AseelKurdy/smart-parking-lot/docs/poster.pdf

## Smart Parking

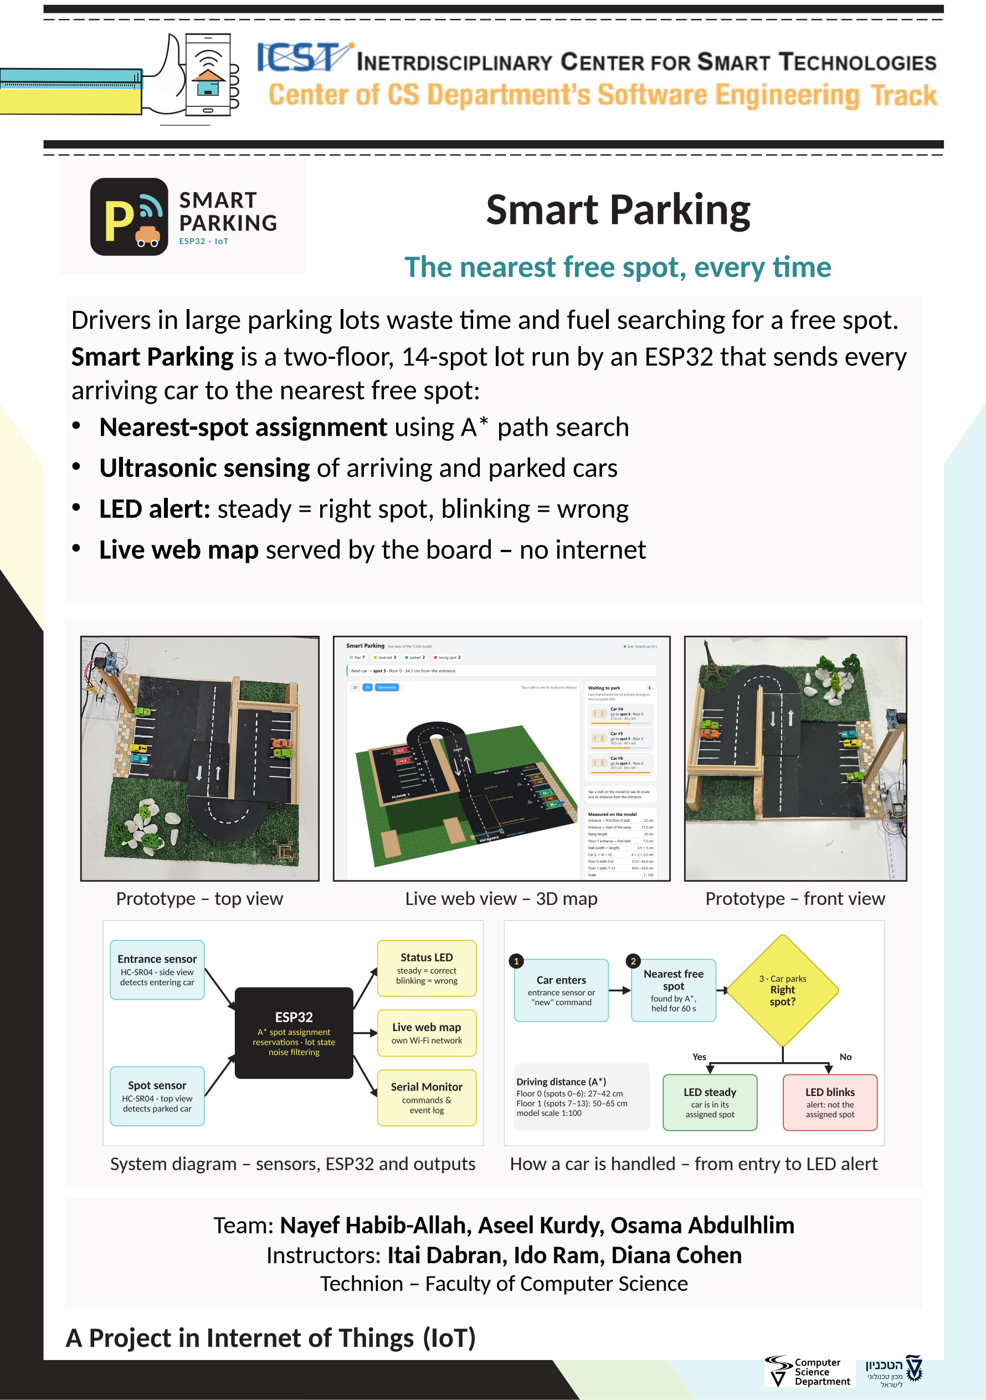
[picture p11: page 1]

A Project in Internet of Things (IoT)

The nearest free spot, every time Drivers in large parking lots waste time and fuel searching for a free spot. Smart Parking is a two-floor, 14-spot lot run by an ESP32 that sends every arriving car to the nearest free spot:
- Nearest-spot assignment using A* path search
- Ultrasonic sensing of arriving and parked cars
- LED alert: steady = right spot, blinking = wrong
- Live web map served by the board – no internet

Team: Nayef Habib-Allah, Aseel Kurdy, Osama Abdulhlim Instructors: Itai Dabran, Ido Ram, Diana Cohen Technion – Faculty of Computer Science

Prototype – top view | Live web view – 3D map | Prototype – front view
System diagram – sensors, ESP32 and outputs | How a car is handled – from entry to LED alert
