AseelKurdy/smart-parking-lot/docs/project_documentation.pdf

Smart Parking · Aseel Kurdy · Nayef Habiballah · Osama Abdulhalim · 1 / 12

# חניון חכם — תיעוד הפרויקט

### מערכת ניהול חניון מבוססת 32ESP עם חיישני אולטרסאונד והקצאת חניות בעזרת A*

| גרסת המסמך 2.1
)2026 אוקטובר , שנמדד דגם )parking_page.h + smart_parking_v9.ino | המתועדת התוכנה גרסת
| תאריך 24/10/2026
Aseel Kurdy, Nayef Habiballah, Osama Abdulhalim | מגישים
Itai Dabran, Ido Ram, Diana Cohen | מנחים
github.com/AseelKurdy/smart-parking-lot | המקור קוד

Smart Parking · Aseel Kurdy · Nayef Habiballah · Osama Abdulhalim · 2 / 12

## .1 תקציר מנהלים

המערכת מנהלת חניון חכם בן שתי קומות ו14- חניות, הבנוי כדגם פיזי בקנה מידה .1:100 כאשר רכב נכנס לחניון, המערכת מקצה לו אוטומטית את החניה הפנויה הקרובה ביותר לכניסה, לפי מרחק נסיעה שמחושב באלגוריתם A* על גבי רשת הדרכים של הדגם — במרחקים שנמדדו על הדגם עצמו. אם הרכב חונה בחניה שהוקצתה לו — נורית החניה דולקת באור קבוע; אם הוא חונה בחניה אחרת — הנורית מהבהבת כאתראה. מתוך 14 החניות, חניה אחת )מספר 0( ממומשת בחומרה אמיתית עם חיישן אולטרסאונד ונורית; 13 הנותרות וירטואליות ונשלטות דרך ה-Monitor Serial. חיישן נוסף בכניסה מזהה כל רכב שנכנס. בנוסף לממשק הטקסטואלי, הלוח מגיש עמוד אינטרנט גרפי שמצייר את הדגם עצמו במבט מלמעלה — שתי הקומות, הרמפה וה-U, החניות והרכבים בפרופורציות האמיתיות — ומעדכן אותו בזמן אמת, כולל תצוגת D3 שבה קומה 1 מורמת מעל קומה .0

## .2 הגדרת הבעיה והדרישות

### 2.1 הבעיה

בחניונים גדולים נהגים מבזבזים זמן ודלק בחיפוש אחר חניה פנויה. חניון חכם שיודע אילו חניות פנויות ומכוון כל רכב לחניה ספציפית יכול לקצר את מרחק הנסיעה בתוך החניון.

### 2.2 דרישות פונקציונליות

# דרישה מימוש

1F זיהוי רכב הנכנס לחניון )חישה מהצד( חיישן 04SR-HC בכניסה

2F זיהוי רכב החונה בחניה )חישה מלמעלה( חיישן 04SR-HC מעל חניה 0

3F הקצאת חניה לרכב נכנס A *על רשת הדרכים — החניה הפנויה הקרובה ביותר

4F זיהוי חניה במקום שגוי השוואה בין החניה המשוריינת לחניה בפועל

5F אתראה על חניה שגויה נורית מהבהבת )300 ms)

6F זיהוי מספר רכב לא ממומש בדרישות הפרויקט — מדומה במונה מזהים עולה

7F חניות וירטואליות נוספות 13 חניות נשלטות דרך ה-Monitor Serial

8F הדמיה ויזואלית של מצב החניון עמוד אינטרנט שהלוח מגיש בעצמו, מחקה את הדגם ב-D/3D2

### 2.3 דרישות לא-פונקציונליות

המערכת פועלת עצמאית, ללא חיבור לאינטרנט או לשרת חיצוני. זמן תגובה: רכב בכניסה ~1.1 שניות )2 דגימות(, רכב בחניה 0 ~2 שניות )4 דגימות × 500 ms). עמידות בפני רעש חשמלי בקריאות החיישנים. הפלט הטקסטואלי באנגלית בלבד — ה-Monitor Serial של IDE Arduino אינו תומך בכיווניות מימין לשמאל.

Smart Parking · Aseel Kurdy · Nayef Habiballah · Osama Abdulhalim · 3 / 12

## .3 ארכיטקטורת המערכת

### 3.1 שכבות

┌──────────────────────────────────────────────────────┐
│ Browser (phone / laptop) | │
│ parking_page.h -> HTML + CSS + JavaScript | │
│ draws the model (SVG, 2D/3D) from JSON, every 1 s | │
└───────────────────────┬──────────────────────────────┘ │ HTTP over WiFi AP "SmartParking"
│ GET / | -> the page
│ GET /state | -> JSON (~1.5 KB)
┌───────────────────────┴──────────────────────────────┐
│ ESP32 - smart_parking_v9.ino | │
│ ┌────────────┬──────────────┬─────────────────────┐ │
│ │ sensors | │ lot logic | │ output | │ │
│ │ sampling | │ road network │ JSON, Serial, LED | │ │
│ │ hysteresis │ A*, states | │ text map (fallback) │ │
│ └────────────┴──────────────┴─────────────────────┘ │ └──────┬────────────────────────────────────┬──────────┘
HC-SR04 x2 | LED GPIO2
(entrance, spot 0)
| ▲
│ Serial 9600 - operator commands

### 3.2 חלוקת האחריות

רכיב אחריות

32ESP דגימת חיישנים, חישוב A*, ניהול מצב החניון, הגשת JSON ו-HTTP

דפדפן כל הציור הגרפי — ה32-ESP אינו מייצר תמונה, רק נתונים

Monitor Serial קלט פקודות + יומן אירועים )וציור טקסט כגיבוי כשאין WiFi)

נורית 2GPIO אתראה על חניה 0 בלבד

הפרדה זו נבחרה במכוון: ציור על ה32-ESP היה צורך זיכרון ו-CPU מיותרים, בעוד שהדפדפן מצייר בחינם מנתונים קומפקטיים.

Smart Parking · Aseel Kurdy · Nayef Habiballah · Osama Abdulhalim · 4 / 12

## .4 החומרה

### 4.1 רשימת רכיבים

| | רכיב כמות תפקיד
ראשי בקר | 1 | ( USB: CH9102 שבב )ESP32-WROOM32 DevKit
| | 04SR-HC — חיישן אולטרסאונד 2 זיהוי כניסה וזיהוי חניה
| | Breadboard 2 חיווט
| | חוטי Jumper 8 חיבור החיישנים
| | כבל USB 1 הזנה ותקשורת
| | נורית LED — מובנית בלוח )2GPIO)
| | דגם החניון 1 לוח עם דשא, כביש ראשי, קומה ,0 רמפה ומשטח מוגבה )קומה 1(

### 4.2 חיווט

Echo | Trig | GND | Vcc | תפקיד
D14 | D27 | GND | VIN (5 V) | ) מהצד ) כניסה חיישן
D25 | D26 | GND | VIN (5 V) | ) מלמעלה )0 חניה חיישן
| | | | נורית אתראה — — — 2GPIO( מובנה(

הערה על מתח: ה04-SR-HC מחזיר פולס Echo ברמת 5 V, ופיני ה32-ESP מיועדים ל3.3- V. בפרויקט זה, לפי אישור מפורש של המנחה, החיישנים חוברו ישירות ללא מחלק מתח. המערכת פעלה ללא תקלה, אך זו חריגה מהמפרט הרשמי.

### 4.3 כיול החיישנים )נמדד על הדגם(

| | | חיישן ללא רכב עם רכב הסף בקוד
ס"מ | ~22 ס"מ רכב נספר מתחת ל25.0- | החיישן( | כניסה )מהצד( ~30 ס"מ )הקיר שמול
מגיע מתחת ל,24.7- יוצא מעל 24.9 | ס"מ(: 23.5–24.5 | 25–26 ס"מ רכב בגובה 2.5 ס"מ: 22.5–23.5; רכב נמוך )1.5 | חניה 0 )מלמעלה(
נקבע | , | בכניסה | הזיהוי | סף )GATE_CAR_BELOW_CM = 25.0 , GATE_ENTRY_CM = 22.0 , GATE_EMPTY_CM = 30.0 :בקוד
. SPOT_LEAVE_CM = 24.9 , SPOT_ARRIVE_CM = 24.7 ,) | ישירות
על המרווחים בחניה :0 הספים נבחרו כך שגם רכב נמוך, בגובה 1.5 ס"מ, ייקלט. בין הקריאה הרחוקה ביותר של רכב כזה )24.5( לבין הקריאה הקרובה ביותר בלי רכב )25.0( יש רק 0.5 ס"מ, ולכן נשארים כ0.2- ס"מ מצד הרכב וכ0.1-ס"מ מצד החניה הריקה — ברמת הדיוק של ה04-SR-HC. ההיסטרזיס )שני ספים( והדרישה ל4- דגימות רצופות הם שמונעים קפיצות. אם יש קפיצות, מודדים עם 10 check ומזיזים את הספים, או מגביהים את החיישן כך שהחניה הריקה תקרא רחוק יותר.

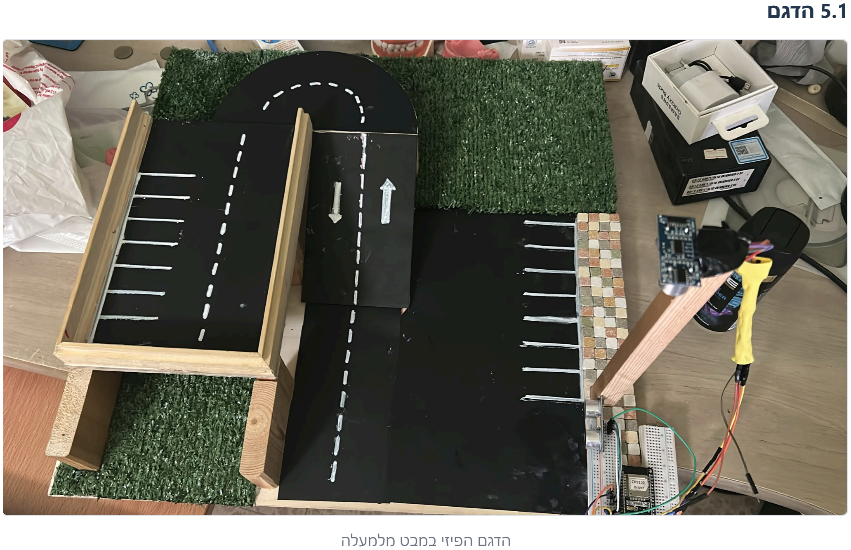
[picture p17: figure]
5.1 הדגם; הדגם הפיזי במבט מלמעלה

Smart Parking · Aseel Kurdy · Nayef Habiballah · Osama Abdulhalim · 5 / 12

## .5 מודל החניון

הכביש הראשי נכנס מלמטה. קומה 0 היא השטח הפתוח מימין לכביש, עם 7 החניות לאורך הקיר הימני — חניה ,0 הקרובה לכניסה, למטה, ועליה חיישן החניה. הרמפה מתחילה על הכביש הראשי עוד לפני חניות קומה ,0 עולה )קטע דו-סטרי( ומסתובבת ב-U אל קומה 1 — המשטח המוגבה משמאל, עם 7 החניות לאורך צדו השמאלי; חניה 7 היא הראשונה מכניסת הקומה.

### 5.2 מידות שנמדדו

| | גודל ערך קבוע בקוד
, CAR_WIDTH_CM , CAR_LENGTH_CM CAR_HEIGHT_CM | ס"מ | רכב )אורך × רוחב × גובה( 4 × 2 × 2.5
SPOT_LENGTH_CM , SPOT_WIDTH_CM | מ"ס 5 × 2.5 | ( אורך × רוחב ) חניה
| | כניסה ← ממש לפני החניה הראשונה בקומה 0 22 ס"מ CM_0FLOOR_TO_ENT
| | כניסה ← תחילת הרמפה 17.5 ס"מ CM_RAMP_TO_ENT
| | אורך הרמפה )עד הכניסה לקומה 1( 20 ס"מ CM_RAMP
FLOOR1_TO_FIRST_CM | מ"ס 7.5 | כניסה לקומה 1 ← ממש לפני החניה הראשונה בה

קנה מידה :1:100 חניה של 2.5 × 5 ס"מ בדגם היא בדיוק חניה סטנדרטית של 2.5 × 5 מ', ורכב של 4 × 2 ס"מ הוא רכב של 4 × 2 מ'. לכן כל ס"מ בדגם הוא מטר בחניון אמיתי — אותם מספרים.

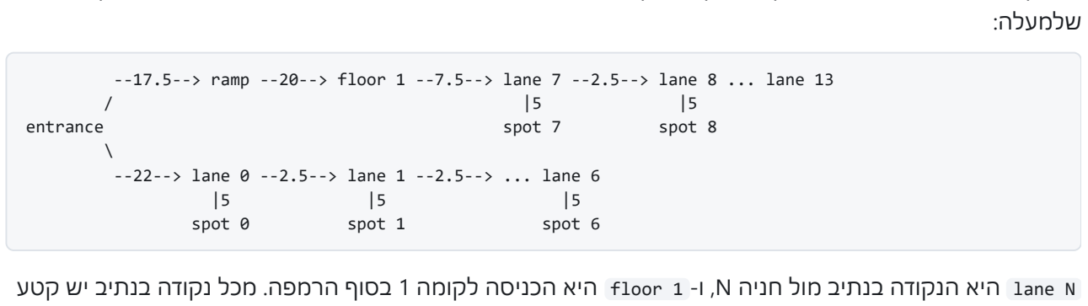
[picture p18: figure]
שלמעלה:; entrance; spot 7; spot 8; spot 0; spot 1; spot 6

Smart Parking · Aseel Kurdy · Nayef Habiballah · Osama Abdulhalim · 6 / 12

### 5.3 רשת הדרכים

החניון מיוצג כרשת של צמתים וקטעי דרך באורך שנמדד. הרשת נבנית בהפעלה ) buildRoadNetwork ) מהקבועים

--17.5--> ramp --20--> floor 1 --7.5--> lane 7 --2.5--> lane 8 ... lane 13

--22--> lane 0 --2.5--> lane 1 --2.5--> ... lane 6

N lane היא הנקודה בנתיב מול חניה N, ו- 1 floor היא הכניסה לקומה 1 בסוף הרמפה. מכל נקודה בנתיב יש קטע של 5 ס"מ )אורך החניה( לתוך החניה שמולה. אי אפשר לנסוע דרך חניה — חניה היא רק יעד.

### 5.4 מרחקי הנסיעה המתקבלים

חניה קומה מרחק מהכניסה בחניון אמיתי )1:100(

0 )פיזית( 0 27.0 ס"מ 27.0 מ'

1 0 29.5 ס"מ 29.5 מ'

2 0 32.0 ס"מ 32.0 מ'

3 0 34.5 ס"מ 34.5 מ'

4 0 37.0 ס"מ 37.0 מ'

5 0 39.5 ס"מ 39.5 מ'

6 0 42.0 ס"מ 42.0 מ'

7 1 50.0 ס"מ 50.0 מ'

8 1 52.5 ס"מ 52.5 מ'

9 1 55.0 ס"מ 55.0 מ'

10 1 57.5 ס"מ 57.5 מ'

11 1 60.0 ס"מ 60.0 מ'
12 1 62.5 ס"מ 62.5 מ'

13 1 65.0 ס"מ 65.0 מ'

לדוגמה: חניה 0 = 22 )עד מול החניה( + 5 )לתוך החניה( = 27.0; חניה 7 = 17.5 + 20 + 7.5 + 5 = 50.0; וכל חניה נוספת באותה קומה מוסיפה .2.5 ה-A *מחשב את כל הערכים האלה מהרשת, ובדיקה אוטומטית משווה אותם לנוסחה הזו )סעיף 10(.
גרסת המחקר ) research_9v_parking_smart ) זהה בדיוק, אבל מציגה את אותם מספרים כמטרים של חניון אמיתי — כמו בסימולציה ובדו"ח.

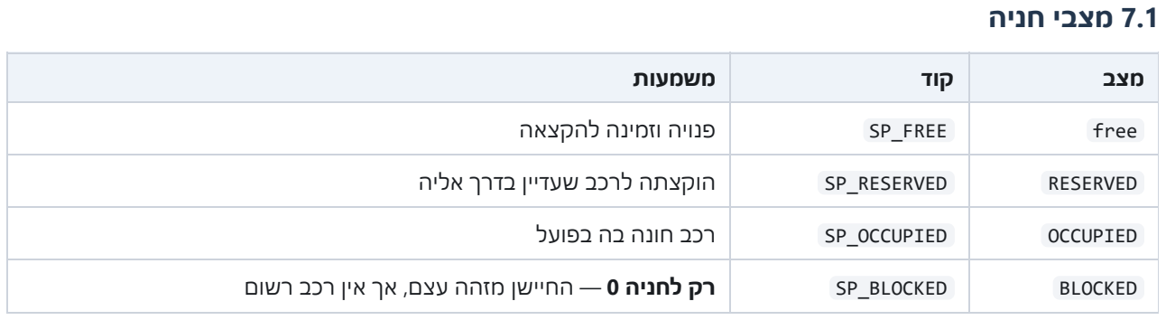
[picture p19: figure]
7.1 מצבי חניה; מצב קוד משמעות; free FREE_SP פנויה וזמינה להקצאה

Smart Parking · Aseel Kurdy · Nayef Habiballah · Osama Abdulhalim · 7 / 12

## .6 אלגוריתם ההקצאה

### 6.1 הבחירה

נבחר A *לפי דרישת הפרויקט. מרחב החיפוש הוא רשת הדרכים: 31 צמתים )כניסה, תחילת רמפה, כניסה לקומה ,1 נקודה בנתיב מול כל אחת מ14- החניות, ובתוך כל חניה( ו30- קטעי דרך.

### 6.2 למה רשת ולא טבלה

בגרסאות קודמות החניון היה טבלה )grid )עם צעד קבוע. במדידות של הדגם הרמפה מתחילה לפני חניות קומה 0 )17.5 ס"מ מול 22 ס"מ(, והקטע הראשון ארוך בהרבה מהמרווח בין החניות — טבלה עם צעד קבוע לא יכולה לייצג את זה. ברשת כל קטע מקבל את אורכו המדוד.

h(n) = SPOT_LENGTH_CM | if n is not on the goal's lane
h(n) = |position of n on the lane - position of the goal| * SPOT_WIDTH_CM + SPOT_LENGTH_CM

הוכחת קבילות )admissibility): כל מסלול לחניה מסתיים בקטע של 5 ס"מ לתוך החניה, ולכן CM_LENGTH_SPOT אינו גדול מהמרחק שנשאר. מנקודה על הנתיב של אותה קומה צריך בנוסף לנסוע לאורך הנתיב עד מול החניה — לפחות מספר החניות שביניהן כפול .2.5 לכן h אף פעם אינה מעריכה ביתר, ו-A *מחזיר את המסלול הקצר ביותר.

### 6.4 מימוש

החישוב מתבצע פעם אחת. הדגם קבוע, ולכן ()computeSpotDistances בונה את הרשת ומריצה A *ל14-היעדים ב- ()setup . בזמן ריצה לא מתבצע חיפוש. אין סגירת צמתים )set closed): צומת יכול להיפתח מחדש אם נמצא לו מסלול זול יותר. ברשת בת 31 צמתים העלות זניחה.
הערה על יעילות: כיוון שהכניסה קבועה, ריצה אחת של Dijkstra הייתה מחזירה את כל המרחקים בבת אחת. ההבדל זניח, ו-A *נבחר כפי שהוגדר בדרישות.

## .7 מודל המצב

RESERVED RESERVED_SP הוקצתה לרכב שעדיין בדרך אליה

OCCUPIED OCCUPIED_SP רכב חונה בה בפועל

BLOCKED BLOCKED_SP רק לחניה 0 — החיישן מזהה עצם, אך אין רכב רשום

סדר העדיפויות: תפוסה ← משוריינת ← חסומה ← פנויה. מצב BLOCKED נדרש משום שהחיישן אינו יודע מי נמצא בחניה; חפץ שמונח שם בלי שרכב הוקצה לא משויך לאף רכב, והחניה אינה מוקצית עד שתתפנה.

Smart Parking · Aseel Kurdy · Nayef Habiballah · Osama Abdulhalim · 8 / 12

### 7.2 מעגל החיים של רכב

[new / entrance sensor]
│
▼
┌─────────────┐
│ RESERVED │ <- A* picked a stall; 60 s timer runs └──┬───────┬──┘
park | │ | │ timeout 60 s
│ | | └───────────┐
▼ | | ▼
┌────────────┐ | ┌───────────────┐
│ PARKED | │ | │ in the lot, | │
│ right/wrong│ | │ no stall | │
└─────┬──────┘ | └──────┬────────┘
│ leave / spot-0 | │ park (always WRONG)
│ sensor clears | │
▼ | | ▼
┌─────────────────────────────┐
│ | left the lot | │
└─────────────────────────────┘

### 7.3 מנגנון השריון

כשרכב נכנס, החניה שהוקצתה לו מסומנת RESERVED ואינה מוצעת לרכבים אחרים )תיקון לבאג מוקדם שבו כל רכב חדש קיבל את אותה חניה(. השריון פוקע לאחר 60 שניות; הרכב נשאר בחניון ויכול עדיין לחנות, אך כל חניה שיתפוס תסומן כשגויה.

### 7.4 השתלטות על חניה משוריינת

אם רכב א' חונה בחניה שהוקצתה לרכב ב', המערכת אינה דוחה את הפעולה — פיזית אי אפשר למנוע זאת. החניה נרשמת על רכב א' ) SPOT WRONG) , ורכב ב' מקבל הקצאה חדשה ) [REROUTE ;) [אם אין חניה פנויה, רכב ב' יוצא מהחניון.

## .8 מנגנוני עמידות ברעש

| | תופעה פתרון קבוע
| קריאה מתחת ל2- ס"מ נפסלת 2.0 = CM_VALID_MIN | פולסים חשמליים קצרים על קו ה-Echo )0.1–0.0 ס"מ(
| | הפרעה הדדית בין שני החיישנים השהייה של 60 ms בין המדידות 60 = MS_DELAY_CROSSTALK
| | ריצוד סביב סף בחניה 0 שני ספים )היסטרזיס( CM_ARRIVE_SPOT / CM_LEAVE_SPOT
| | קריאה בודדת שגויה בחניה 0 4 דגימות רצופות ועקביות 4 = SAMPLES_CONFIRM_SPOT
, GATE_CONFIRM_SAMPLES GATE_CLEAR_SAMPLES | 2 דגימות רצופות לאישור, 2 "ריק" לפני רכב הבא | רכב עקמומי שמקפיץ את קריאת הכניסה
firstSample | מצב | אירוע שווא ברגע ההפעלה הדגימה הראשונה רק מאתחלת

דגימה לא תקינה בחניה 0 מאפסת את מונה האישורים — הרעש מגיע בפרצים.

Smart Parking · Aseel Kurdy · Nayef Habiballah · Osama Abdulhalim · 9 / 12

## .9 מהלך הפיתוח

| גרסה שינוי עיקרי
| 1v קריאת שני חיישנים והדפסת מרחקים
| 2v היסטרזיס, מזהי רכב מפורשים בפקודות, פקודת check
| 3v תיקון שגיאת קומפילציה ) struct בחתימת פונקציה( — הוחלף במערכים
| 4v גישת החיישנים שנבדקה בפועל: דגימה כל 500 ms, השהיית talk-cross
| 5v ביטול הדפסה רציפה; המרחקים רק דרך check
| 6v מנגנון שריון, רכב אחד–חניה אחת
רכב מזהה לפי leave <id> , park <spot> <id> | v7
| 8v יציאה בחיישן חניה ,0 פקיעת שריון, ניתוב מחדש, המלצה לרכב הבא, טיפול ברעש, מצב BLOCKED
| 9v עמוד אינטרנט גרפי, status מרענן את התמונה, רשימת רכבים ממתינים
מרחקים ומידות שנמדדו על הדגם )ס"מ(, רשת דרכים ו-A *חדש, כיול חדש לשני החיישנים, תמונה שמחקה את הדגם ב-D/3D2 | 9v( דגם שנמדד(

### 9.1 באגים משמעותיים שנמצאו ותוקנו

.1 Trig ו-Echo הוחלפו פיזית בחיישן הכניסה — תוקן בקוד, על ידי החלפת מספרי הפינים. .2 חיישן החניה נתקע לנצח — רצועת היסטרזיס משותפת מיקמה את קריאת החניה הריקה בתוך האזור המת. תוקן בספים נפרדים.
.3 אותו רכב חנה בשתי חניות — נוספה בדיקה ()whereIsCarParked . .4 כל רכב חדש קיבל את אותה חניה — נוסף מצב RESERVED . .5 "רכבי רפאים" בהפעלה — תוקן ב- firstSample . .6 רכבי רפאים מרעש בחניה 0 — חיישן החניה אינו יוצר רכבים, ורעש מאפס את האישור.

## .10 בדיקות

כל הבדיקות נמצאות בתיקייה /tests ורצות על המחשב, בלי הלוח )פירוט ב- md.README/tests) .

### 10.1 איך בודקים בלי חומרה

הקובץ ino9.v_parking_smart עצמו, בלי שינוי, מקומפל על המחשב יחד עם תחליפים לחומרה: פורט סריאלי, שעון, שני חיישני ה04-SR-HC( כולל מודל רעש(, הנורית ושרת האינטרנט. כך אפשר להזיז "רכב" מול חיישן, לקרוא את הנורית ולבדוק את ה-JSON שהעמוד מקבל.

Smart Parking · Aseel Kurdy · Nayef Habiballah · Osama Abdulhalim · 10 / 12

### 10.2 תוצאות

| | בדיקה מה נבדק תוצאה
54 מתוך 54 עברו | נורית, נתוני התמונה | חבילת הבדיקות ) Sim- 1ps.tests_run ) 38 הבדיקות המקוריות + 16 חדשות: חיישנים,
161,040 פעולות, 0 הבדלים | עצמאי של הכללים | בדיקת מודל אקראית ) py.model_fuzz ) אחרי כל פעולה, מצב הקושחה מול מימוש
13 מתוך 13 | ממתינים, גודל ה-JSON | מקרי קצה ) py.cases_edge ) מזהים תלת-ספרתיים, יותר מ16- רכבים
גרסת המחקר( | המהדר והספריות האמיתיים של 32ESP עובר, בלי אזהרות )גם | קומפילציה ל32-ESP ) esp32_syntax_check.ps1 (
1,029 מצבים, 0 הבדלים | ומונה בציור מול הנתונים | עמוד האינטרנט בדפדפן מאות מצבים אמיתיים מהקושחה; כל רכב, סימון

בין הבדיקות: כל 14 המרחקים מול הנוסחה של סעיף 5.4; סף הכניסה בדיוק ב25- ס"מ )24.9 = רכב, 25.1 = ריק(; ספי חניה 0 מול טווחי המדידה )25.0 ו26.0- אינם רכב; 24.5 — רכב נמוך — ו23.5- הם רכב; ותחום 24.7–24.9 אינו משנה מצב(; רכב שעומד מול חיישן הכניסה נספר פעם אחת; רעש ואי-הד אינם יוצרים אירועים; ונורית קבועה / מהבהבת. על הלוח עצמו: חבילת 38 הבדיקות רצה על הלוח האמיתי ב10/10/2026- )גרסת 8v )ועברה במלואה, 38 מתוך .38 הגרסה הנוכחית רצה על הלוח בהדגמה המצולמת ב18/10/2026- )הסרטון(: זיהוי רכב בכניסה, חיישן חניה ,0 שריון שפג, חניה במקום לא נכון, הנורית ועמוד האינטרנט שמוגש מה32-ESP.

### 10.3 מה לא נבדק אוטומטית

חבילת הבדיקות האוטומטית עוד לא הורצה מחדש על הלוח עם הגרסה הנוכחית )ההתנהגות על הלוח נבדקה ידנית

.) tests/README.md | ראו )run_tests.ps1 -Port COMx :כך | אותה | מריצים | .( | המצולמת | בהדגמה

## .11 מגבלות ידועות

מגבלה השלכה

חיישן חניה פיזי יחיד רק חניה 0 מזוהה אוטומטית; 13 הנותרות דרך פקודות

מרווח צר בחניה 0 ~0.2 ס"מ מצד רכב נמוך ו-~0.1 ס"מ מצד החניה הריקה )סעיף 4.3(

אין זיהוי רכב אמיתי המזהה הוא מונה עולה; רכב שמגיע לחניה 0 משויך בהנחה

רכב ששריונו פג נשאר ברשימת הממתינים עד leave

500 = CARS_MAX לאחר 500 רכבים נדרשת הפעלה מחדש

ציור הטקסט ב9600- baud כ1.4- שניות לציור, כשה-WiFi כבוי

העמוד הגרפי לצפייה בלבד כל השליטה דרך ה-Monitor Serial אין שמירה מתמדת כיבוי הלוח מאפס את מצב החניון

Smart Parking · Aseel Kurdy · Nayef Habiballah · Osama Abdulhalim · 11 / 12

## .12 פרויקטים דומים שנסקרו

| פרויקט רלוונטיות
| parking-smart/Kadacheahmedrami (https://github.com/Kadacheahmedrami/smart-parking) 6 חיישני 04SR-HC + לוח בקרה. אותם פינים שנבחרו כאן
זיהוי RFID מול טבלה — התבנית למעבר לזיהוי אמיתי | Muhaiminul-Hasan/RFID-based-Smart-Parking-System-using-ESP32 (https://github.com/Muhaiminul-Hasan/RFID-based-Smart-Parking-System-using-ESP32)
אנומליות מזהים החיישנים ; servo שער ,FreeRTOS, RFID | AHD184/esp32-freertos-smart-parking-system (https://github.com/AHD184/esp32-freertos-smart-parking-system)
סף כיול : לאימוץ רעיון ; ESP32-CAM מפעיל HC-SR04 בלחיצת כפתור | AmerWegzyy/IOT_ParkMe (https://github.com/AmerWegzyy/IOT_ParkMe)

אף אחד מהפרויקטים האלה אינו מממש את הכלל חניה נכונה ← אור קבוע, חניה שגויה ← הבהוב — זו התרומה המקורית של הפרויקט.

## .13 עבודה עתידית

.1 העלאה ללוח והרצת החבילה על החומרה, עם ציור הטקסט מופעל ) true = MAP_TEXT) . .2 כיול בלחיצת כפתור — שמירת המרחק הנמדד כסף, במקום עריכת קבועים. .3 RFID אמיתי )522MFRC )במקום מונה המזהים. .4 חיישנים נוספים לחניות נוספות — המבנה תומך בכך דרך INDEX_SPOT_REAL . .5 חיווט טוב יותר לחיישן החניה — הפרדת חוטי Echo/Trig וקבל 10 µF על ההזנה, נגד רעש חשמלי.

## .14 נספחים

נספח א' — קבצי הפרויקט

| קובץ / תיקייה תיאור
הקושחה — חיישנים, רשת הדרכים ו-A*, לוגיקת החניון, שרת HTTP | :GitHub-ב )smart_parking_v9/smart_parking_v9.ino ) firmware/smart_parking_v9/
לשבת חייב ( — HTML/CSS/JS( האינטרנט עמוד באותה תיקייה | smart_parking_v9/parking_page.h
אמיתי | /research_9v_parking_smart אותה קושחה, מרחקים במטרים בקנה מידה
קצה, קומפילציה ל32-ESP | /tests סימולטור, חבילת הבדיקות, בדיקת מודל, מקרי
| /simulation סימולציית החניון בגודל אמיתי )Python )לדו"ח
| /report הדו"ח )מאמר( והסקריפטים שבונים אותו
| /docs בניית ה-PDF של שלושת המסמכים ותמונות

Smart Parking · Aseel Kurdy · Nayef Habiballah · Osama Abdulhalim · 12 / 12

נספח ב' — מילון מונחים

מונח הסבר

שריון )Reservation )הקצאת חניה לרכב שטרם הגיע אליה

היסטרזיס שני ספים שונים למעבר בין מצבים, למניעת ריצוד

talk-Cross הפרעה הדדית בין שני חיישני אולטרסאונד

היוריסטיקה קבילה הערכה שאינה מעריכה ביתר את המרחק שנשאר

(Point Access (AP הלוח פותח רשת WiFi משלו

קנה מידה 1:100 ס"מ אחד בדגם = מטר אחד במציאות
