AseelKurdy/smart-parking-lot/docs/screenshots/01_wifi_join_smartparking.png

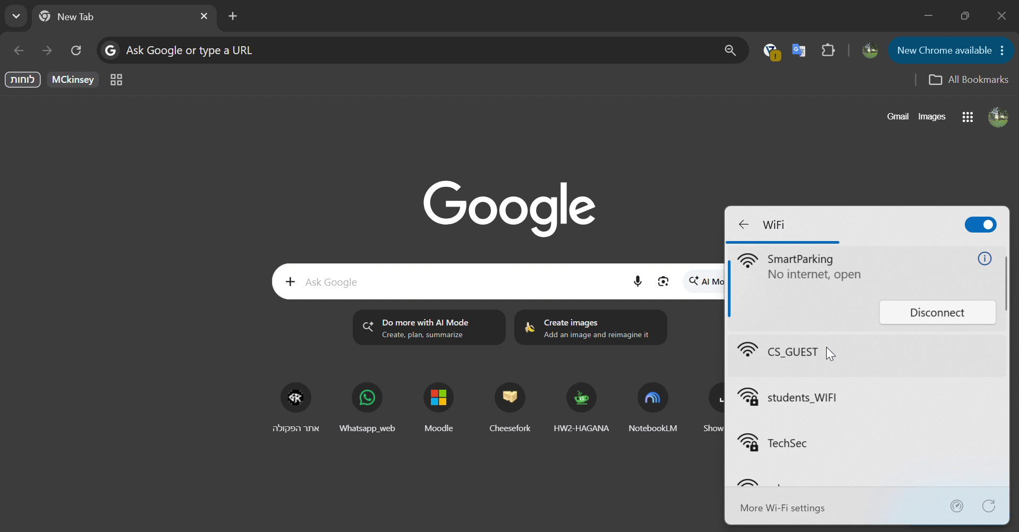
docs/screenshots/01_wifi_join_smartparking.png
