AseelKurdy/smart-parking-lot/docs/screenshots/02_dashboard_live_empty_lot.png

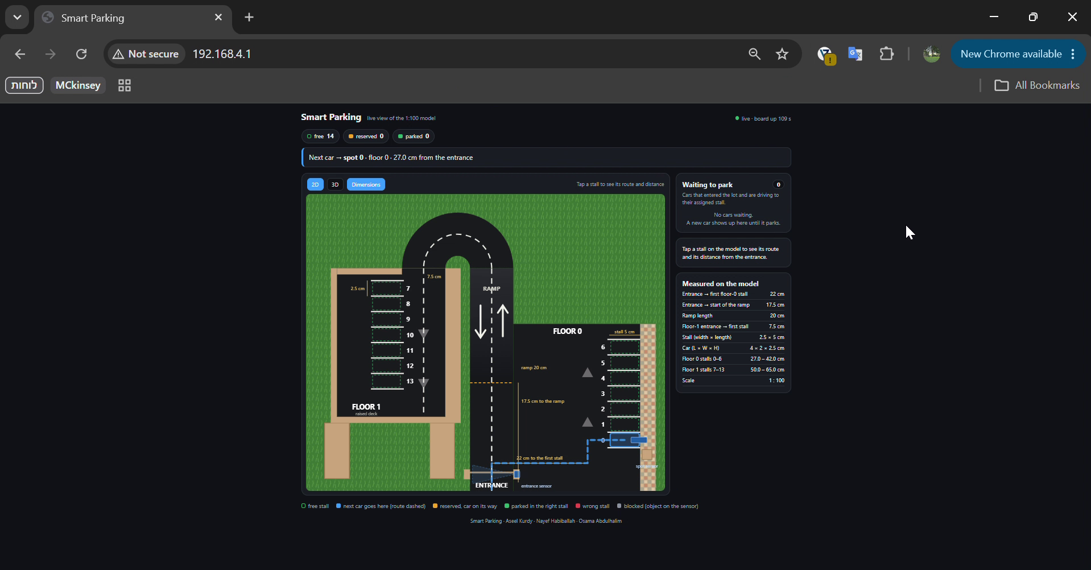
docs/screenshots/02_dashboard_live_empty_lot.png
