AseelKurdy/smart-parking-lot/docs/screenshots/08_wrong_spot_red_with_serial_log.png

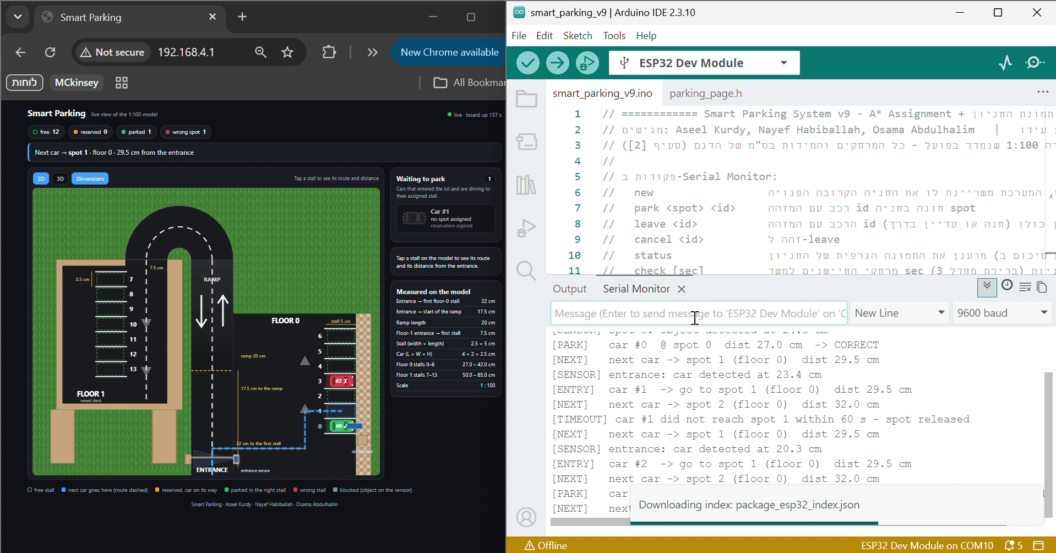
docs/screenshots/08_wrong_spot_red_with_serial_log.png
