AseelKurdy/smart-parking-lot/docs/screenshots/10_serial_monitor_check_readings.png

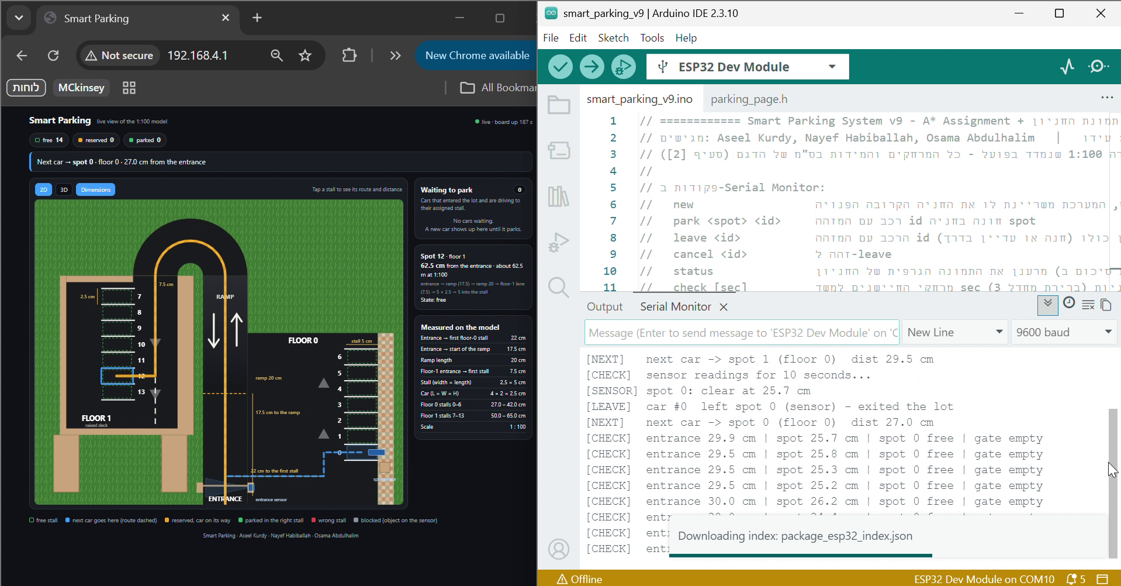
docs/screenshots/10_serial_monitor_check_readings.png
