AseelKurdy/smart-parking-lot/simulation/figures/fig3_sensitivity.png

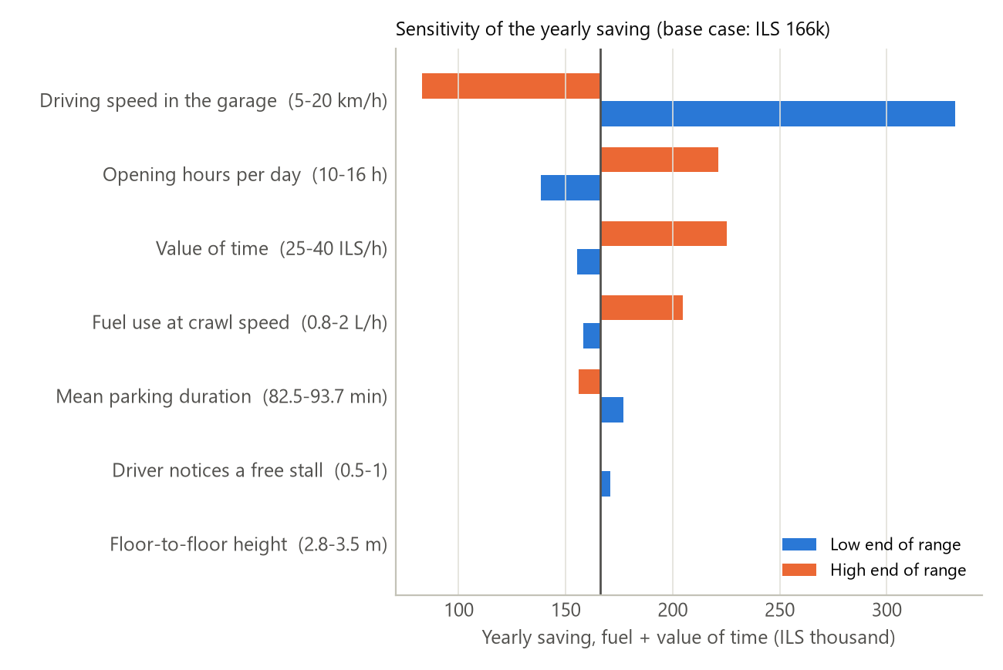
simulation/figures/fig3_sensitivity.png
