AseelKurdy/smart-parking-lot/simulation/results/headline.csv

lot | compared_with | occupancy | assigned_entry_m | assigned_exit_m | baseline_entry_m | baseline_exit_m | saved_m_per_car | saved_m_ci95 | saved_s_per_car | saved_ml_fuel_per_car | saved_g_co2_per_car | saved_ils_fuel_per_car | saved_ils_time_per_car | cars_per_year | saved_hours_per_year | saved_litres_per_year | saved_kg_co2_per_year | saved_ils_fuel_per_year | saved_ils_time_per_year | turned_away_share | baseline_m_when_lot_full
Demo lot (14 stalls, 2 floors) | Searching alone, p = 1 | 0.8520095238095239 | 32.70445062114989 | 32.70445062114989 | 32.70445062114989 | 32.70445062114989 | 0.0 | 0.0 | 0.0 | 0.0 | 0.0 | 0.0 | 0.0 | 35336.07370234785 | 0.0 | 0.0 | 0.0 | 0.0 | 0.0 | 0.25028333333333336 | 111.0
Demo lot (14 stalls, 2 floors) | Searching alone, p = 0.5 | 0.8520095238095239 | 32.70445062114989 | 32.70445062114989 | 43.041698600179956 | 33.70164183634746 | 11.334439194227642 | 0.3939771473474798 | 4.080398109921951 | 1.1334439194227643 | 2.663593210643496 | 0.00937358121362626 | 0.030954353439435693 | 35336.07370234785 | 40.05145787420082 | 40.05145787420082 | 94.12092600437192 | 331.2255566196407 | 1093.8053145444244 | 0.25028333333333336 | 111.0
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
