AseelKurdy/smart-parking-lot/simulation/results/occupancy_sweep.csv

lot | p | target_occupancy | occupancy | occupancy_ci95 | turned_away_share | turned_away_share_ci95 | assigned_search_m | assigned_search_m_ci95 | assigned_exit_m | assigned_exit_m_ci95 | assigned_full_lot_m | assigned_full_lot_m_ci95 | cruising_search_m | cruising_search_m_ci95 | cruising_exit_m | cruising_exit_m_ci95 | cruising_full_lot_m | cruising_full_lot_m_ci95 | random_search_m | random_search_m_ci95 | random_exit_m | random_exit_m_ci95 | random_full_lot_m | random_full_lot_m_ci95 | arrival_rate_per_min | arrival_rate_per_min_ci95 | assigned_total_m | assigned_total_m_ci95 | cruising_total_m | cruising_total_m_ci95 | random_total_m | random_total_m_ci95 | saved_vs_cruising_m | saved_vs_cruising_m_ci95 | saved_vs_random_m | saved_vs_random_m_ci95 | entry_reduction_vs_cruising | entry_reduction_vs_cruising_ci95
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
