AseelKurdy/smart-parking-lot/simulation/results/occupancy_sweep_replications.csv

occupancy | turned_away_share | assigned_search_m | assigned_exit_m | assigned_full_lot_m | cruising_search_m | cruising_exit_m | cruising_full_lot_m | random_search_m | random_exit_m | random_full_lot_m | seed | arrival_rate_per_min | assigned_total_m | cruising_total_m | random_total_m | saved_vs_cruising_m | saved_vs_random_m | entry_reduction_vs_cruising | lot | p | target_occupancy
0.5148095238095238 | 0.009000000000000008 | 24.162697611839892 | 24.162697611839892 | 0.0 | 24.162697611839892 | 24.162697611839892 | 111.0 | 63.49149007736292 | 34.42018163471241 | 379.9259259259259 | 0 | 0.0801484711099508 | 48.325395223679784 | 48.325395223679784 | 97.91167171207533 | 0.0 | 49.58627648839555 | 0.0 | demo | 1.0 | 0.5
0.49033333333333334 | 0.008333333333333304 | 23.296470588235294 | 23.296470588235294 | 0.0 | 23.296470588235294 | 23.296470588235294 | 111.0 | 60.97764705882352 | 34.37865546218487 | 346.52 | 1 | 0.0801484711099508 | 46.59294117647059 | 46.59294117647059 | 95.35630252100839 | 0.0 | 48.7633613445378 | 0.0 | demo | 1.0 | 0.5
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
