AseelKurdy/smart-parking-lot/simulation/results/sensitivity.csv

parameter | label | range_text | low | high | base
search_visibility_p | Driver notices a free stall | 0.5-1 | 170999.79783699557 | 166068.51119545574 | 166068.51119545574
fuel_rate_l_per_h | Fuel use at crawl speed | 0.8-2 L/h | 158348.51913482381 | 204668.47149861537 | 166068.51119545574
search_speed_kmh | Driving speed in the garage | 5-20 km/h | 332137.0223909115 | 83034.25559772787 | 166068.51119545574
value_of_time_ils_per_h | Value of time | 25-40 ILS/h | 155286.66013133255 | 225298.68002823633 | 166068.51119545574
operating_hours_per_day | Opening hours per day | 10-16 h | 138390.42599621313 | 221424.681593941 | 166068.51119545574
mean_stay_min | Mean parking duration | 82.5-93.7 min | 177139.74527515282 | 155966.15779295738 | 166068.51119545574
floor_rise_m | Floor-to-floor height | 2.8-3.5 m | 166068.5111954557 | 166068.51119545574 | 166068.51119545574
