AseelKurdy/smart-parking-lot/simulation/results/validation.csv

p | target_occupancy | occupancy | extra_search_s | entry_driving_reduction | benchmark_offstreet_search_s | benchmark_reduction_low | benchmark_reduction_high
1.0 | 0.5 | 0.5029881172839507 | 17.9586138 | 0.43185960436192844 | 50 | 0.162 | 0.5
1.0 | 0.6 | 0.6036045524691358 | 21.773433599999997 | 0.4376313913388176 | 50 | 0.162 | 0.5
1.0 | 0.7 | 0.7043467592592593 | 25.230012000000006 | 0.4351845579037083 | 50 | 0.162 | 0.5
1.0 | 0.8 | 0.8041408179012345 | 28.738358108284636 | 0.4333224828572071 | 50 | 0.162 | 0.5
1.0 | 0.85 | 0.8534342592592594 | 30.576054752645977 | 0.43389396492895643 | 50 | 0.162 | 0.5
1.0 | 0.9 | 0.9024554783950617 | 32.37338715433613 | 0.4352161376203851 | 50 | 0.162 | 0.5
1.0 | 0.95 | 0.951715200617284 | 34.0372845381705 | 0.4359617149378784 | 50 | 0.162 | 0.5
1.0 | 0.98 | 0.9805603395061728 | 34.764201998267446 | 0.43668291496612965 | 50 | 0.162 | 0.5
0.5 | 0.5 | 0.5029881172839507 | 18.3428052 | 0.4370540452554475 | 50 | 0.162 | 0.5
0.5 | 0.6 | 0.6036045524691358 | 22.465122000000008 | 0.4453058431565483 | 50 | 0.162 | 0.5
0.5 | 0.7 | 0.7043467592592593 | 25.82481599999999 | 0.44088234809185634 | 50 | 0.162 | 0.5
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
