AseelKurdy/smart-parking-lot/(commit log)

2026-10-23 Smart Parking Lot: ESP32 firmware, tests, simulation and documents
    ESP32 parking system on a 1:100 physical model: ultrasonic sensing,
    A* stall allocation with 60 s reservations, and a live 2D/3D web
    dashboard served by the board. Includes the host-simulator test suite
    (54/54), model-based fuzzing, the Python simulation study, the paper
    and the project manuals.
    [headline.csv, occupancy_sweep.csv, occupancy_sweep_replications.csv, parameters.csv, sensitivity.csv, validation.csv]
2026-10-23 README: fix diagrams, accurate road-network map, prominent video link
    - Replace both Mermaid diagrams with SVG images. GitHub's renderer
    failed on the architecture diagram ("Unable to render rich display").
    - Redraw the road network in the model's real layout with every stall's
    distance. The old graph's "..." nodes made 5 lane steps look like 2,
    and stall 13 was cut off.
    - Add a "Watch the demo video" button under the cover photo, make the
    demo GIF link to the release, and list the MP4 link explicitly.
2026-10-24 Stage-3 submission: research document, updated manuals, poster, screenshots
    - Add the research document (docs/research_document.pdf) in the course's
    required structure, with the simulation user and programmer guides,
    parameters and sources, and the two manuals as appendices. It replaces
    the earlier long paper (report/), removed here.
    - Update the three manuals to the current firmware: entrance threshold
    25 cm, spot 0 at 24.7/24.9 cm (cars 1.5-2.5 cm high), demo run on the
    board, repository link, instructors.
    - Add the poster and ten screenshots of the running system.
    - Re-run the full test suite on the current firmware: 54/54 passed.
    - README: link the research document, poster and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
